dresco/PowerMeter/(list of files, drawings)

Other design files:
hardware/PowerMeter.dsn
