dresco/PowerMeter/hardware/PowerMeter.sch

## KiCad design hardware/PowerMeter.sch (2011-11-07)

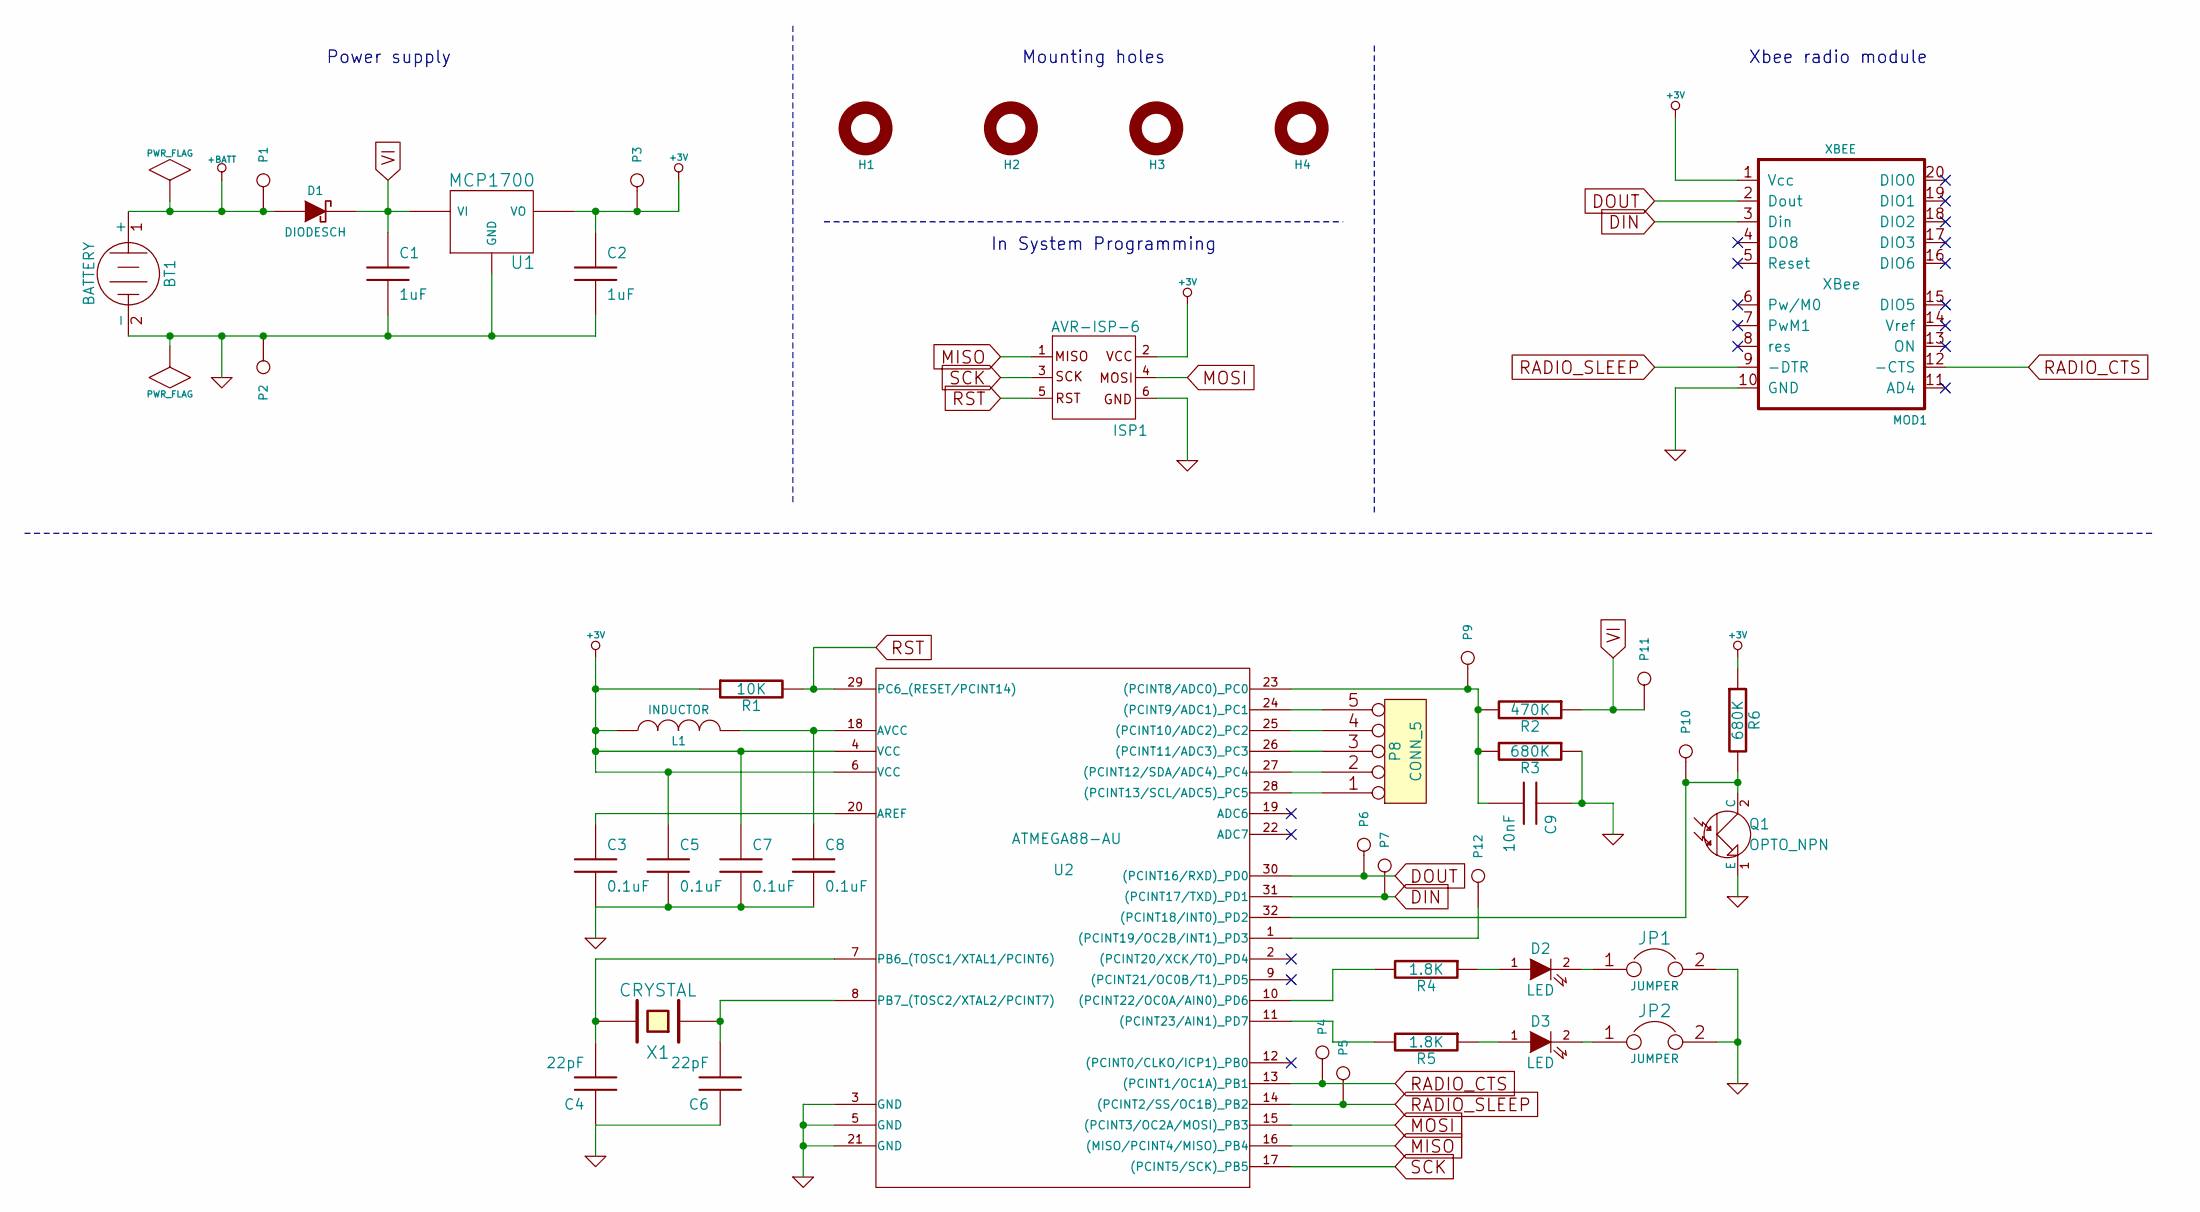
[picture p1: schematic PowerMeter.sch]

Parts:
BT1: BATTERY
C1, C2: 1uF
C3, C5, C7, C8: 0.1uF
C4, C6: 22pF
C9: 10nF
D1: DIODESCH
D2, D3: LED
H1, H2, H3, H4: HOLE
ISP1: AVR-ISP-6
JP1, JP2: JUMPER
L1: INDUCTOR
MOD1: XBEE; XBee
P1, P2, P3, P4, P5, P6, P7, P9, P10, P11, P12: CONN_1
P8: CONN_5
Q1: OPTO_NPN
R1: 10K
R2: 470K
R3, R6: 680K
R4, R5: 1.8K
U1: MCP1700
U2: ATMEGA88-AU
X1: CRYSTAL

Connections:
+3V: C2.1, C5.1, C7.1, ISP1.2, L1.1, MOD1.1 (Vcc), P3.1, R1.1, R6.1, U1.VO, U2.4 (VCC), U2.6 (VCC)
+BATT: BT1.1 (+), D1.1 (A), P1.1
DIN: MOD1.3 (Din), P7.1, U2.31 ((PCINT17/TXD)_PD1)
DOUT: MOD1.2 (Dout), P6.1, U2.30 ((PCINT16/RXD)_PD0)
GND: BT1.2 (-), C1.2, C2.2, C3.2, C4.1, C5.2, C6.1, C7.2, C8.2, C9.1, ISP1.6, JP1.2, JP2.2, MOD1.10 (GND), P2.1, Q1.1 (E), R3.1, U1.GND, U2.3 (GND), U2.5 (GND), U2.21 (GND)
MISO: ISP1.1, U2.16 ((MISO/PCINT4/MISO)_PB4)
MOSI: ISP1.4, U2.15 ((PCINT3/OC2A/MOSI)_PB3)
unnamed: C3.1, U2.20 (AREF)
unnamed: C4.2, U2.7 (PB6_(TOSC1/XTAL1/PCINT6)), X1.2
unnamed: C6.2, U2.8 (PB7_(TOSC2/XTAL2/PCINT7)), X1.1
unnamed: C8.1, L1.2, U2.18 (AVCC)
unnamed: C9.2, P9.1, R2.2, R3.2, U2.23 ((PCINT8/ADC0)_PC0)
unnamed: D2.1 (A), R4.1
unnamed: D2.2 (K), JP1.1
unnamed: D3.1 (A), R5.1
unnamed: D3.2 (K), JP2.1
unnamed: P8.1, U2.28 ((PCINT13/SCL/ADC5)_PC5)
unnamed: P8.2, U2.27 ((PCINT12/SDA/ADC4)_PC4)
unnamed: P8.3, U2.26 ((PCINT11/ADC3)_PC3)
unnamed: P8.4, U2.25 ((PCINT10/ADC2)_PC2)
unnamed: P8.5, U2.24 ((PCINT9/ADC1)_PC1)
unnamed: P10.1, Q1.2 (C), R6.2, U2.32 ((PCINT18/INT0)_PD2)
unnamed: P12.1, U2.1 ((PCINT19/OC2B/INT1)_PD3)
unnamed: R4.2, U2.10 ((PCINT22/OC0A/AIN0)_PD6)
unnamed: R5.2, U2.11 ((PCINT23/AIN1)_PD7)
RADIO_CTS: MOD1.12 (-CTS), P4.1, U2.13 ((PCINT1/OC1A)_PB1)
RADIO_SLEEP: MOD1.9 (-DTR), P5.1, U2.14 ((PCINT2/SS/OC1B)_PB2)
RST: ISP1.5, R1.2, U2.29 (PC6_(RESET/PCINT14))
SCK: ISP1.3, U2.17 ((PCINT5/SCK)_PB5)
VI: C1.1, D1.2 (K), P11.1, R2.1, U1.VI

Notes on the sheet:
Xbee radio module
In System Programming
Power supply
Mounting holes
