dresco/PowerMeter/(commit log)

2011-09-07 Initial schematic
    [$savepcb.brd, PowerMeter.brd, PowerMeter.sch]
2011-09-25 Updated schematic, initial board layout
    [$savepcb.brd, PowerMeter.brd, PowerMeter.sch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]
2011-09-30 Updated board layout
    [$savepcb.brd, PowerMeter.brd, PowerMeter.sch]
2011-10-01 Minor updates
    [$savepcb.brd, PowerMeter.brd, PowerMeter.dsn, PowerMeter.sch]
2011-10-02 Re-orient MCU and headers
    [$savepcb.brd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]
2011-10-03 Reduce solder mask clearance
    [PowerMeter.brd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]
2011-10-04 Ignore temporary and backup files
    [$savepcb.brd]
2011-10-04 Tweak mask clearance again
    [PowerMeter.brd]
2011-10-05 Move top connectors down .025"
    [PowerMeter.brd]
2011-10-05 Tweak board outline, re-plot gerbers
    [PowerMeter.brd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]
2011-10-05 Move some text labels, add to-do notes to board and schematic
    [PowerMeter.brd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]
2011-10-07 Move batt+ ADC input after diode, move XBee module within board outline
    [PowerMeter.brd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]
2011-10-07 Move via
    [PowerMeter.brd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]
2011-10-07 Slight tweak to filled zone
    [PowerMeter.brd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]
2011-10-07 Remove a via from input signal line
    [PowerMeter.brd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]
2011-10-08 Add new test point for VIN, use one via for both XTAL caps
    [PowerMeter.brd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]
2011-10-08 Add new test point for INT1
    [PowerMeter.brd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]
2011-10-09 Prepare for manufacturing, bump version number, add license text
    [PowerMeter.brd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]
2011-10-09 Minor silkscreen tweaks
    [PowerMeter.brd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]
2011-10-09 Better test point names on silkscreen
    [PowerMeter.brd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]
2011-10-09 Add more license info
    [PowerMeter.brd, PowerMeter.sch]
2011-10-19 Added README and symlinks with correct naming conventions for seeed fusion service
    [powermeter.gbl, powermeter.gbo, powermeter.gbs, powermeter.gtl, powermeter.gto, powermeter.gts]
2011-10-19 Move board outline to back silkscreen layer - ready for seeed order
    [PowerMeter.brd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]
2011-10-19 Seed Fusion order number added to back silkscreen layer
    [PowerMeter.brd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]
2011-10-31 Create back annotation file with component footprints
2011-11-07 Adjust a couple of resistor values following initial build
    [PowerMeter.sch]
2011-11-08 Create eclipse project for source code, fix compile errors/warnings
    [osccal.c, powermeter.c]
2011-11-09 Change I/O port definitions to reflect new board layout
2011-11-10 Correct CPU frequency in eclipse project settings, fine-tune ADC values
    [powermeter.c]
2011-11-13 Minor firmware tweaks, loaded onto board
2011-11-13 Update a couple of resistor values on board to match previous schematic change
    [PowerMeter.brd]
2011-11-18 Move board outline back to pcb edges layer
    [PowerMeter.brd]
