dresco/PowerMeter/(notices)

Notices in the files:
hardware/PowerMeter.sch:
Released under Creative Commons Attribution-Sharealike (CC BY-SA 3.0) license
